Thilanka-Dissanayake/2D-Drawing-Bot/16882 Final Report_1a57fe1e69968b14cc38ac35d5213708.pdf

## DEPARTMENT OF PHYSICS

## UNIVERSITY OF COLOMBO

Embedded System Laboratory (PH3032)

## 2D Drawing Machine

By Serial Communication

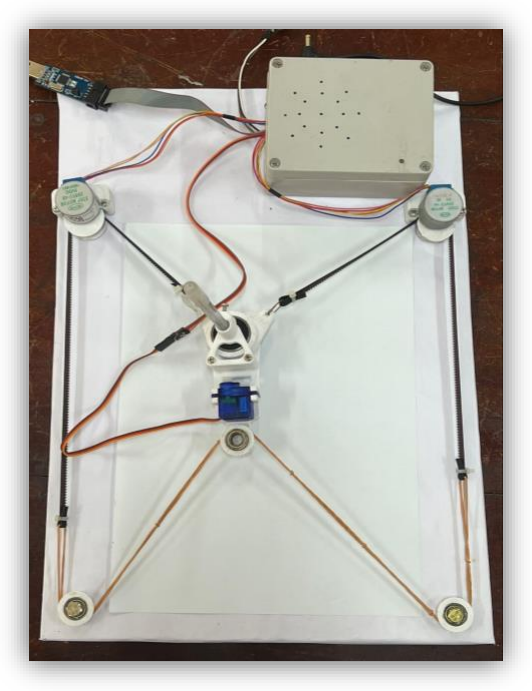
[picture p1: figure]

Name: Thilanka Dissanayake

Index No: 16882

Registration No: 2022s19374

Date: September 15, 2025

## 1. Abstract

This report presents a detailed account of the design, development, and testing of a 2D Drawing Machine, a low-cost Cartesian plotter controlled by a personal computer. The primary objective of this project was to create an educational tool demonstrating core concepts in embedded systems, mechatronics, and automation. The system architecture is centered around an ATmega328P microcontroller, which orchestrates the movement of two 28BYJ-48 stepper motors for X-Y axis control and a SG90 servo motor for actuating a pen-lift mechanism.

A custom-designed Printed Circuit Board (PCB) integrates the microcontroller with motor drivers and other peripheral components, ensuring a stable and compact hardware foundation. The mechanical structure is built using 3D-printed parts, bearings, and a belt-drive system to translate motor rotation into precise linear motion.

Communication between a host PC and the microcontroller is achieved via a USB-TTL serial interface, enabling the transmission of drawing commands. The firmware, written in C, implements a parser for a G-code-like command set and utilizes Bresenham's line algorithm for efficient, integer-based path interpolation. On the host side, a Python script provides a high-level interface for users, containing functions to draw various predefined geometric shapes and patterns by generating and sending the appropriate command sequences.

Performance tests demonstrate the machine's ability to successfully render complex shapes with reasonable accuracy. Analysis of the results identified potential sources of error, including mechanical backlash, belt tension inconsistencies, and motor step resolution. The project successfully meets its objectives, serving as a functional prototype and a robust platform for future enhancements in the field of hobbyist CNC technology.

## 2.Introduction

## 2.1. Background and Motivation

In the modern era of digital fabrication, Computer Numerical Control (CNC) has become a cornerstone technology, enabling the automated creation of complex parts with high precision. From industrial milling machines to desktop 3D printers, the principle remains the same: translating digital designs into physical objects through controlled motion. The 2D plotter is one of the earliest and most intuitive forms of CNC technology, providing a clear visual representation of digital path planning and motion control.

The motivation for this project stems from a desire to explore these foundational concepts in a hands-on, accessible manner. While commercial CNC machines are often expensive and complex, building a plotter from the ground up provides invaluable insight into the interplay between hardware, firmware, and software. This project, the "2D Drawing Machine," was conceived as an educational endeavor to design and implement a complete mechatronic system using readily available, low-cost components.

## 2.2. Objectives

The primary objectives of this project were defined as follows:

- Design and build a functional Cartesian plotter - capable of moving a pen in a 2D plane.
- Develop a custom electronic control system - based on the ATmega328P microcontroller, including the design and fabrication of a custom PCB.
- Write robust firmware in C - to manage motor control, interpret commands, and execute motion paths using an efficient algorithm.
- Create a user-friendly Python control script - for sending drawing commands from a PC to the plotter via serial communication.
- Achieve reasonable drawing accuracy - for a variety of predefined geometric shapes.
- Document the entire process - including design choices, challenges faced, and potential areas for improvement.

## 2.3. Scope and Limitations

The project's scope is focused on creating a proof-of-concept plotter. It is designed to draw single-color line art from a set of predefined functions. The machine operates on a small drawing area (approximately A5 paper size) and is not intended for high-speed or highprecision applications. Limitations include the inherent speed and torque constraints of the 28BYJ-48 stepper motors, the mechanical rigidity of the 3D-printed frame, and the simplicity of the G-code interpreter, which does not support advanced features like arc interpolation or buffered commands.

## 3.Theoretical Principles

## 3.1. ATmega328P Microcontroller Architecture

The ATmega328P is the central processing unit of the 2D Drawing Machine. It is a highperformance, low-power 8-bit microcontroller based on the AVR enhanced RISC architecture. Its versatility and extensive community support make it an ideal choice for this project

3.1.1 Core and Memory

The ATmega328P features 32 KB of In-System Programmable Flash memory for program storage, 2 KB of SRAM for data variables during runtime, and 1 KB of EEPROM for nonvolatile data storage. The RISC architecture with 131 powerful instructions allows most instructions to execute in a single clock cycle, achieving throughputs approaching 1 MIPS per MHz.

3.1.2 Peripherals

The firmware for this project utilizes several of the ATmega328P's built-in peripherals:

- General Purpose I/O (GPIO):
The GPIO pins on PORTB and PORTD are configured as outputs to send the stepping signals to the ZC-A0591 motor drivers and the PWM signal to the servo motor.
- Timers/Counters:
The 16-bit Timer1 is used in Fast PWM mode to generate the precise 50 Hz PWM signal required for controlling the servo motor's angle. Its configuration involves setting the pre scaler and top value (ICR1) to define the period, and the compare match value (OCR1B) to define the duty cycle.
- Universal Synchronous/Asynchronous Receiver/Transmitter (USART):
The USART module is configured for asynchronous serial communication at a baud rate of 9600 bps to receive commands from the host PC.

## 3.2 Stepper Motor Control

3.2.1 Principles of the 28BYJ-48 Motor

The 28BYJ-48 is a 5-wire unipolar stepper motor. Internally, it has a step angle of 5.625°, meaning it takes 360/5.625=64 steps to complete one full revolution of its rotor. However, it also includes an internal 1/64 reduction gearbox. This results in an effective step count of 64×64=4096 steps per full revolution of the output shaft, providing very high resolution at the cost of speed.

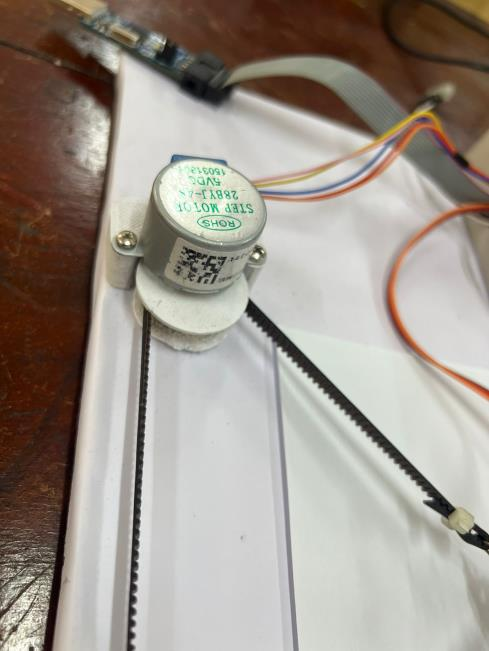
[picture p2: figure]

## Figure 3.1. The stepper motor

3.2.2 ZC-A0591 Driver

The ATmega328P cannot directly provide the current required to drive the stepper motor coils. The ZC-A0591 driver board, which features a ULN2003 Darlington transistor array, acts as a current amplifier. It takes the low-current logic signals from the microcontroller's pins and switches the high-current path from the 5V power supply to the motor coils.

3.2.3 Stepping Modes

The firmware drives the motors using a half-step sequence. In this mode, both single coils and pairs of adjacent coils are energized sequentially. This doubles the motor's resolution (to 8 steps per cycle) and provides smoother rotation compared to full-stepping.

## 3.3 Servo Motor Control

3.3.1 Principle of Operation

The micro servo is a closed-loop control system. It consists of a DC motor, a gearbox, a position feedback potentiometer, and a control circuit. The control circuit receives a PWM signal and compares the corresponding target angle with the current angle read from the potentiometer. It then drives the DC motor until the difference between the two is zero, allowing for precise angular positioning.

3.3.2 Pulse Width Modulation (PWM) on ATmega328P

Standard servos operate on a PWM signal with a 20 ms (50 Hz) period. The width of the pulse within this period determines the angle:

- A ~1 ms pulse corresponds to 0°.
- A ~1.5 ms pulse corresponds to 90° (neutral).
- A ~2 ms pulse corresponds to 180°.

The firmware configures Timer1 in Fast PWM mode with ICR1 set to 19999 and a prescaler of 8. With an 8 MHz clock, this creates a 50 Hz period. The

OCR1B register is then set to a value between 1000 (1 ms) and 2000 (2 ms) to control the pen's angle.

## 3.4 Serial Communication Protocol (UART)

3.4.1 Asynchronous Data Transfer

UART is a form of asynchronous serial communication, meaning no clock signal is shared between the transmitter and receiver. Instead, the data is framed with a start bit and a stop bit to allow the receiver to synchronize. The data format used in this project is 8-N-1 (8 data bits, no parity bit, 1 stop bit), a common standard.

3.4.2 Baud Rate Configuration

Both the PC and the ATmega328P must be configured to operate at the same baud rate (9600 bps) for successful communication. In the firmware, this is achieved by loading a calculated value into the UBRR0 register. The formula used is

UBRR = (FCPU /(16×BAUD)) − 1

For an 8 MHz CPU frequency and 9600 baud, the UBRR value is approximately 51.

# 3.5 Motion Planning: Bresenham's Line Algorithm

## 3.5.1 Algorithm Overview

To draw a line from (x0 ,y0 ) to (x1 ,y1 ), the plotter needs to execute a series of discrete steps in X and Y. Bresenham's algorithm is an optimal method for determining this sequence. It maintains an integer error term that represents the deviation of the current pixel grid point from the true mathematical line. At each iteration, it decides the next step (in X, Y, or diagonally) based on the sign of this error term, then updates the error term accordingly.

## 3.5.2 Implementation Logic

The draw_line function in the C firmware implements this algorithm. It first calculates the total steps required in X (dx) and Y (dy) and their directions (sx, sy). It then enters a loop that continues until both steps_x and steps_y counters reach zero. Inside the loop, an error term err is compared. If the error term indicates that the path is drifting too far in one direction, a corrective step is made in the other direction. This ensures the plotted line remains as close as possible to the ideal straight line, using only efficient integer arithmetic.

# 4. Methodology and Implementation

# 4.1 System Design Overview

The system is divided into three main subsystems:

1. Mechanical System: The physical plotter frame, belts, and pen holder.
2. Electronic System: The custom PCB with the ATmega328P, motor drivers, and power supply.
3. Software System: The C firmware on the microcontroller and the Python control script on the PC.

A user interacts with the Python script, which sends high-level commands. The firmware receives these commands, performs low-level motion planning, and drives the motors to create the final drawing.

# 4.2 Mechanical Design and Assembly

## 4.2.1 Cartesian Frame

The machine's structure was built primarily from 3D-printed parts, designed to be lightweight and easy to assemble. The design follows a CoreXY-like belt arrangement where the position of the central carriage is determined by the coordinated movement of both stepper motors. This design minimizes the moving mass, as the motors themselves are stationary. Copper-coated anti-slip belts are used to transmit motion from the motor pulleys to the pen carriage, with bearings serving as idler pulleys to maintain belt tension and ensure smooth motion.

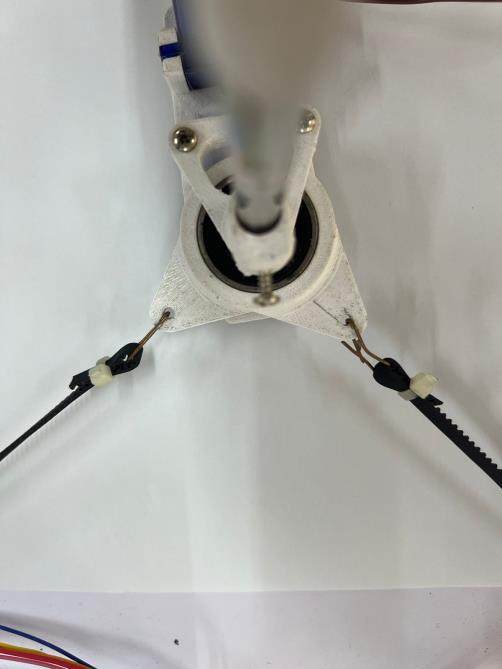
[picture p3: figure]

Figure 4.1.

## 4.2.2 Pen Lift Mechanism

The pen is held in a 3D-printed holder attached to the central carriage. A micro servo motor is mounted on this carriage, with its horn connected to a lever that lifts the entire pen holder assembly up and down. This simple yet effective mechanism allows the machine to move between points without drawing on the paper

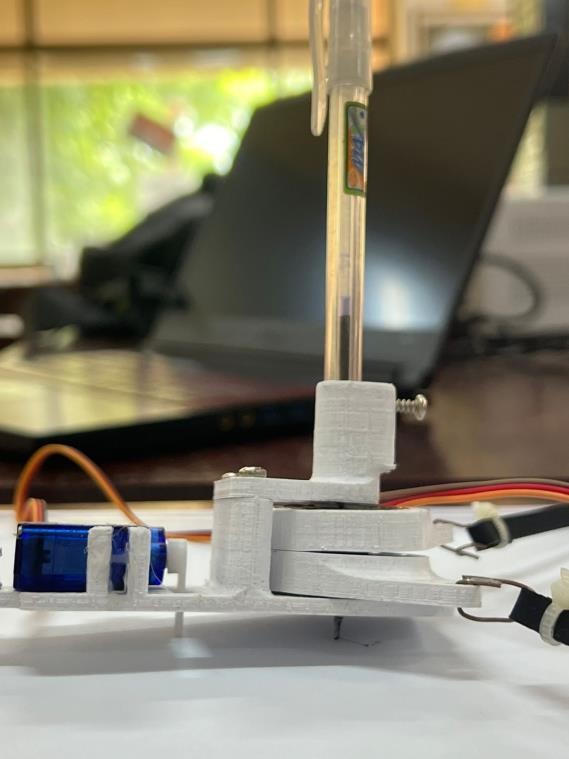
[picture p4: figure]

## Figure 4.2. Operation of the servo motor

# 4.3 Hardware Design and Components

## 4.3.1 Hardware Components

- 1 ATmega328P-PU Microcontroller
- 2 28BYJ-48 Stepper Motors with ZC-A0591 Drivers
- 1 Micro Servo Motor SG90
- 1 USB-TTL CH340 Adapter for Serial Communication
- 1 5V 2A DC Power Adapter
- 3 (8-16mm) Bearings and 2 (12-28mm) Bearings
- 1 Custom designed single-layer PCB with Required Components|
- 3D Printed Parts & belts

## 4.3.2 Component Selection Rationale

- ATmega328P: Chosen for its low cost, wide availability, extensive documentation, and sufficient peripherals for this application.
- 28BYJ-48 Steppers: Selected due to their very low cost and high resolution, making them suitable for a budget-friendly, proof-of-concept plotter where speed is not a primary concern.
- Micro Servo: A standard, inexpensive solution for simple actuation tasks like the pen lift.
- 5V 2A Power Supply: Chosen to provide adequate current for both stepper motors (which can draw several hundred mA each) and the servo, ensuring stable operation.

# 4.4 PCB Design and Schematic

## 4.4.1 Schematic Description

The schematic, designed in EasyEDA, outlines all electrical connections. The ATmega328P is the central component. The schematic includes a 16 MHz crystal oscillator circuit, a reset button with a pull-up resistor, and headers for connecting the two stepper drivers (8 pins total), the servo (3 pins), and the USB-TTL adapter (for power, ground, RX, TX). The motor drivers are powered directly from the main 5V input, while the ATmega328P's VCC is also connected to this rail, potentially through a filtering inductor and capacitor to reduce motor noise.

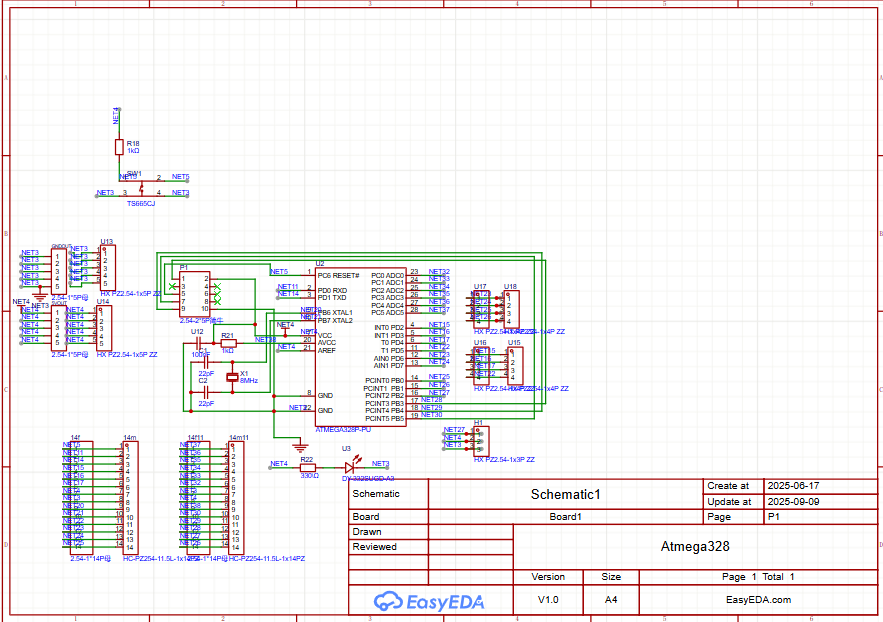
[picture p5: figure]

## Figure 4.1: Circuit Schematic

## 4.4.2 PCB Layout

The PCB is a single-sided board designed for easy home fabrication. Component placement was optimized to keep related components close. Traces for the motor outputs are made wider to handle higher currents. A ground plane is used to improve signal integrity and reduce electrical noise generated by the motors. Headers are grouped logically for easy connection of the external modules.

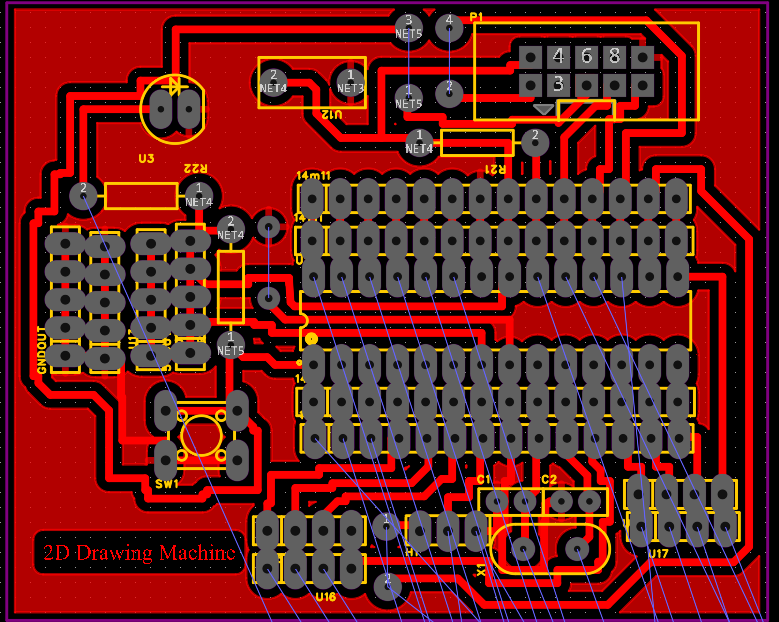
[picture p6: figure]

## Figure 4.2: PCB Layout

# 4.5 Firmware Development (C)

## 4.5.1 Development Environment

The firmware was written in C using an AVR toolchain (avr-gcc, avr-libc) and programmed onto the ATmega328P using an external programmer via the ICSP header on the PCB.

## 4.5.2 Firmware Architecture

The firmware's architecture is based on a simple super-loop. After an initial setup phase, the main function enters an infinite while(1) loop. Inside this loop, it continuously checks for incoming serial data. When a newline character is received, the assembled command string is passed to the process_gcode_command function for parsing and execution. This is a blocking, single-tasking architecture, sufficient for the requirements of this project.

## 4.5.3 Peripheral Initialization

The setup_pins() function configures the data direction registers (DDRB, DDRD) for all motor control pins as outputs. The USART_Init() function configures the baud rate and enables the UART transmitter and receiver. The timerservo_init() function configures Timer1 for Fast PWM mode to drive the servo.

## 4.5.4 Command Processing

The process_gcode_command function acts as the core of the firmware's logic. It uses strcmp and strncmp to identify commands:

- M3/M5: Directly call servo_set_angle to lift or lower the pen.
- G28 (Home): Calculate the steps needed to move from the current_x, current_y position back to (0,0) and execute the movement.
- G1 (Linear Move): Parses the command string using atoi to extract the target X and Y coordinates. It then calculates the delta steps required and calls execute_movement, which in turn calls draw_line. Finally, it updates the global current_x and current_y variables.

# 4.6 Control Software Development (Python)

## 4.6.1 Software Architecture

The Python script is object-oriented, with a DrawingRobot class that encapsulates all communication and control logic. Upon instantiation, the class constructor initializes the serial connection via the pyserial library and waits for a "Ready" message from the firmware, confirming the connection is live. The class provides methods like move_to, pen_up, and pen_down that abstract the underlying G-code commands.

## 4.6.2 High-Level Shape Functions

The script includes functions like draw_square, draw_triangle, and draw_heart. Each of these functions contains the geometric logic to generate a series of (X, Y) waypoints for that shape. It then calls the basic

move_to, pen_down, and pen_up methods in the correct sequence to draw the shape on the machine. For example, draw_square calculates the coordinates of the four corners and sends four G1 commands between them. The draw_heart function uses a parametric equation to generate a dense set of points to approximate a smooth curve.

# 5. Results and Analysis

# 5.1 Experimental Setup

The machine was placed on a flat, stable surface. An A5 sheet of paper was secured to the drawing platform. The machine was powered on with a 5V 2A DC adapter, and the USB-TTL adapter was connected to a host PC running the Python control script. The

draw_shapes.py script was executed from the command line, specifying the correct serial port.

# 5.2 Qualitative Results

The machine was commanded to draw a sequence of shapes, including a square, star, triangle, heart, and letters. The output was visually inspected. The machine successfully drew all shapes, demonstrating that the end-to-end system was functional. The lines were continuous, and the pen lift mechanism worked reliably between separate drawing paths.

Figure 5.1: Sample output of Rectangle from the 2D Drawing Machine.

Figure 5.2: Sample output of Triangle from the 2D Drawing Machine.

Figure 5.3: Sample output of Star from the 2D Drawing Machine.

Figure 5.4: Sample output of Heart from the 2D Drawing Machine.

Figure 5.5: Sample output of House from the 2D Drawing Machine.

The drawings are clearly recognizable. However, some minor artifacts are visible upon close inspection, such as slight waviness in straight lines, Pen lift issues and rounded corners, which are analyzed below.

# 5.3 Error Analysis

Several sources contribute to the observed inaccuracies:

- Mechanical Backlash: There is inherent play in the gearboxes of the 28BYJ-48 motors and slack in the belt system. This causes a small amount of lost motion when the direction of movement changes, leading to rounded corners and slight inaccuracies.
- Frame Rigidity: The 3D-printed frame can flex slightly during rapid movements, causing vibrations that manifest as wavy lines.
- Motor Step Loss: If the pen experiences too much friction or the machine attempts to move too fast, the motors may not have enough torque to complete a step, causing the machine to lose its position. This is mentioned as a potential issue in the user manual's troubleshooting section.
- Belt Tension: Uneven or inadequate belt tension can lead to slipping or stretching, resulting in dimensional inaccuracies and skewing of the drawing.
- Pen Tip Friction: The friction between the pen tip and the paper creates a drag force that the motors must overcome. Variations in this friction can affect positioning accuracy.
- Servo Motor Torque Limitations: The SG90 micro servo motor is lightweight and inexpensive, but it has limited power. When used to lift the pen, the total weight of the pen holder, the pen itself, and especially the 12-28mm bearings in the assembly can exceed the motor's torque capacity.

# 6. Discussion

# 6.1 Performance Evaluation

The 2D Drawing Machine successfully meets all the primary objectives outlined for the project. It demonstrates a complete, functional mechatronic system capable of translating digital commands into physical drawings. The modular design, combining a custom PCB with 3D-printed parts and a Python control interface, proved to be an effective and flexible approach. The firmware's implementation of Bresenham's algorithm is efficient and the G-code-like protocol is robust enough for the intended tasks. The project serves as an excellent educational platform for learning about CNC principles in a practical setting.

# 6.2 Challenges and Solutions

- Challenge: Initial motor movements were jerky and inaccurate.
- Solution: The issue was traced to the stepping mode. Switching from a full-step to a half-step sequence in the firmware (stepper_sequence array) resulted in much smoother motion.
- Challenge: The machine would occasionally lose its position during longer drawings.
- Solution: This was identified as motor step loss due to insufficient power. The troubleshooting guide in the user manual suggests verifying the 5V 2A power supply is used. Additionally, the _delay_ms(1) in the step_motor function was crucial to give the motors time to complete each step, reducing the chance of stalls.
- Challenge: Calibrating the drawing size to match real-world units.
- Solution: The UNIT_STEPS constant in the firmware required significant trialand-error adjustment. A calibration procedure was developed where a line of known length was commanded, and the constant was adjusted until the drawn length matched the expected length.

# 6.3 Future Improvements

While the project was successful, there are numerous avenues for enhancement:

- Upgrade Drive System: Replace the 28BYJ-48 motors with NEMA 17 stepper motors and A4988 drivers. This would dramatically increase speed, torque, and accuracy.
- Improve Mechanical Design: Utilize linear rails or metal rods instead of a purely 3D-printed guide system to increase rigidity and reduce vibrations.
- Advanced Firmware: Implement a command buffer (circular buffer) in the firmware to store multiple G-code commands. This would allow for look-ahead planning and acceleration/deceleration control, resulting in smoother and faster movements, especially for curves.
- Implement Closed-Loop Control: Add rotary encoders to the motors to provide positional feedback, allowing the firmware to detect and correct for lost steps.
- Develop a Graphical User Interface (GUI): Create a desktop application using a framework like PyQt or Tkinter that allows users to load, preview, and draw standard vector graphics files (e.g., SVG), rather than being limited to hard-coded shapes.
- Text Writing: Create python script would have pre-defined G-code templates for each letter, which it would then execute one by one to form words and sentences. This would transform the machine into a simple text-writing robot.
- Image-to-G-code Conversion: Develop a software pipeline that takes a simple blackand-white image as input and converts it into a series of G-code commands. This process would involve edge detection or image tracing to identify the lines and contours, which are then translated into linear (G1) move commands. The Python script could then read and send these commands to the machine, allowing it to "sketch" simple pictures.

# 7. Conclusion

The Design and Implementation of a PC-Controlled 2D Drawing Machine project successfully resulted in the creation of a functional and educational Cartesian plotter. By integrating an ATmega328P microcontroller, stepper and servo motors, a custom PCB, and a Python-based control interface, the project comprehensively covered key aspects of embedded systems engineering and mechatronics. The machine demonstrated its capability to draw various geometric shapes with a degree of accuracy suitable for its low-cost, hobbyist nature.

The development process provided critical insights into the challenges of motion control, including mechanical precision, motor limitations, and the importance of robust firmware. The final prototype, while having scope for improvement, stands as a testament to the power of integrating simple, accessible components to create a complex automated system. It not only fulfills all its initial objectives but also serves as a versatile platform for future exploration and enhancement in the field of digital fabrication.

# 8. Appendix

# 8.1. The C code

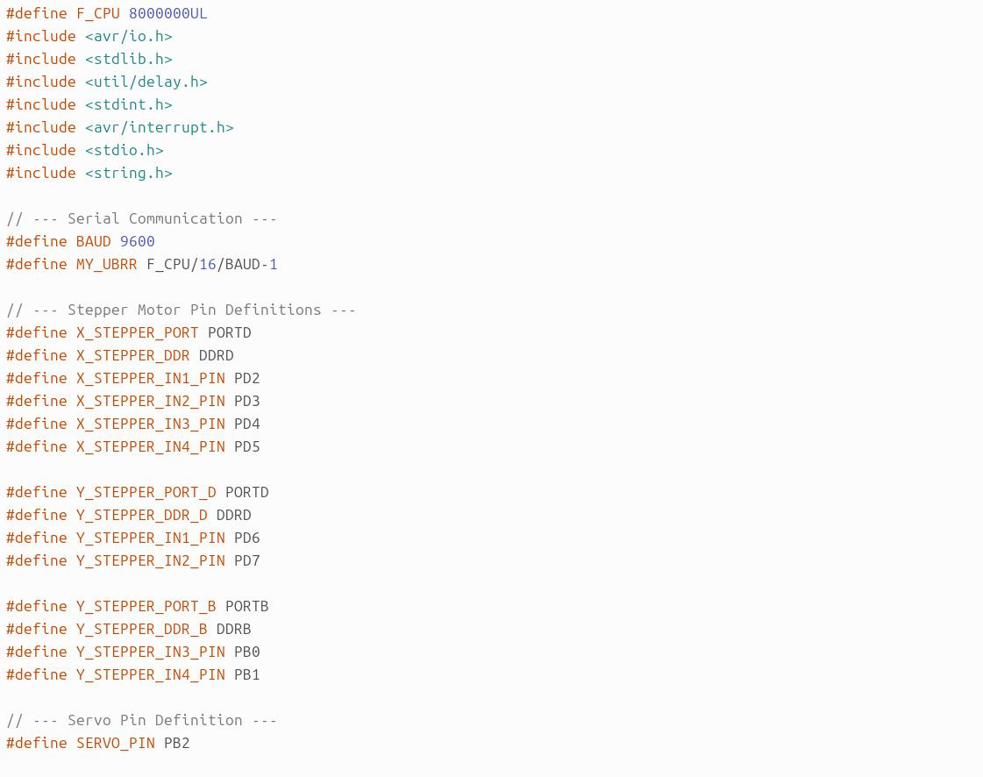
[picture p7: figure]

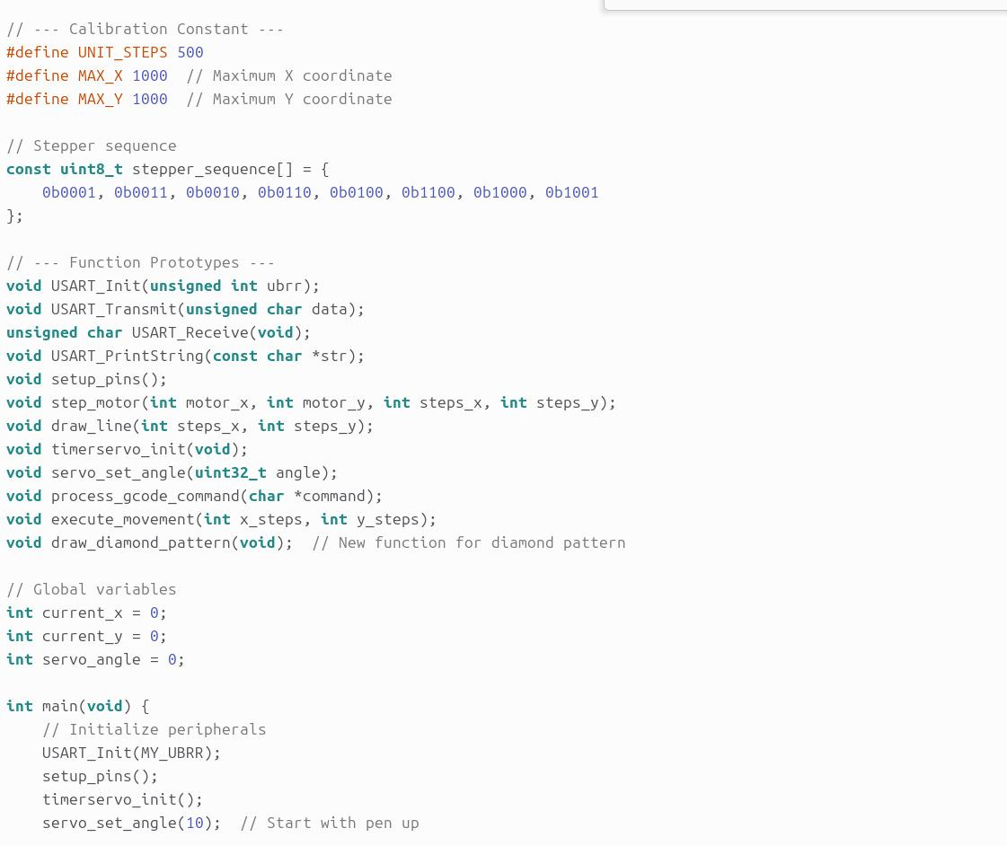
[picture p8: figure]

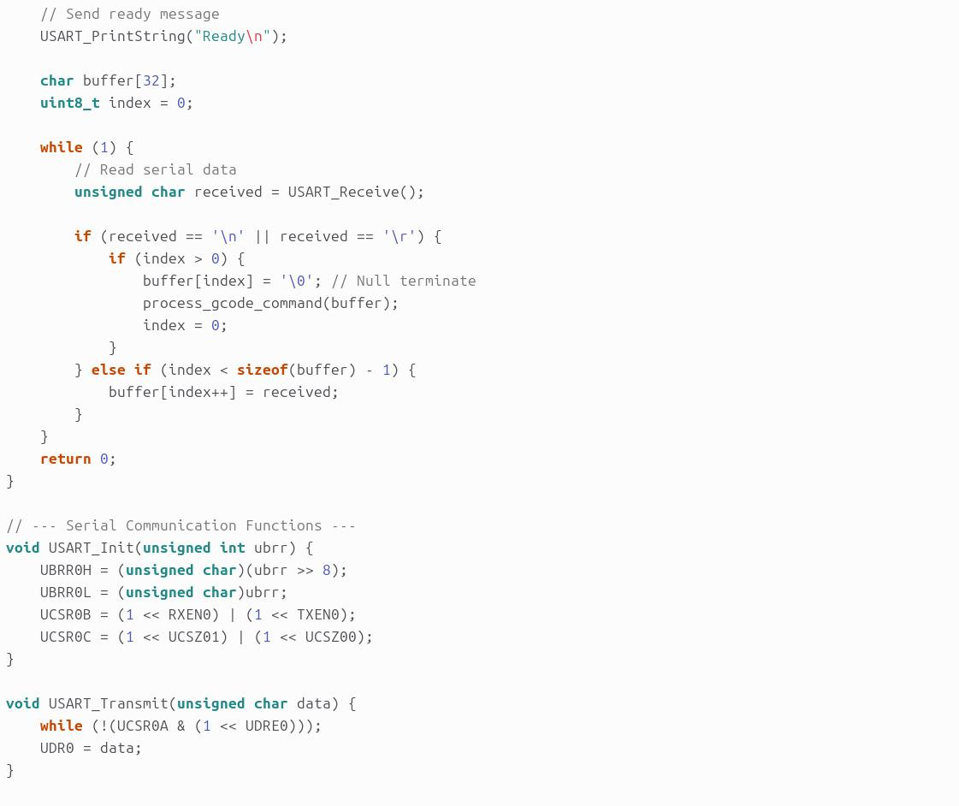
[picture p9: figure]

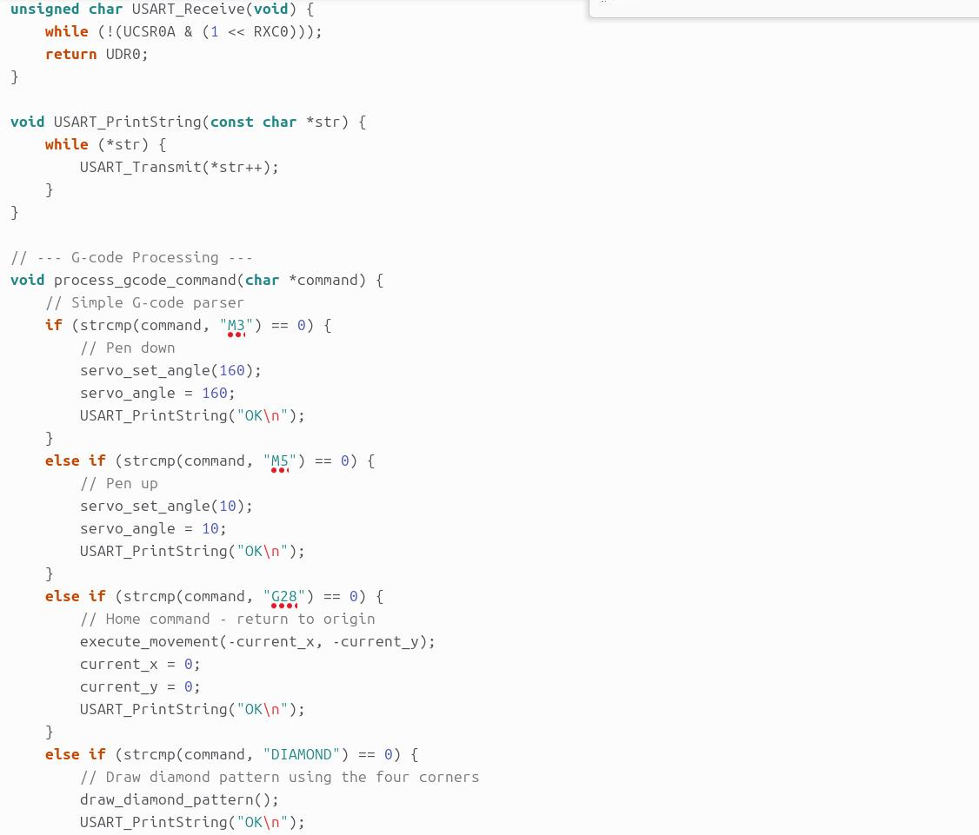
[picture p10: figure]

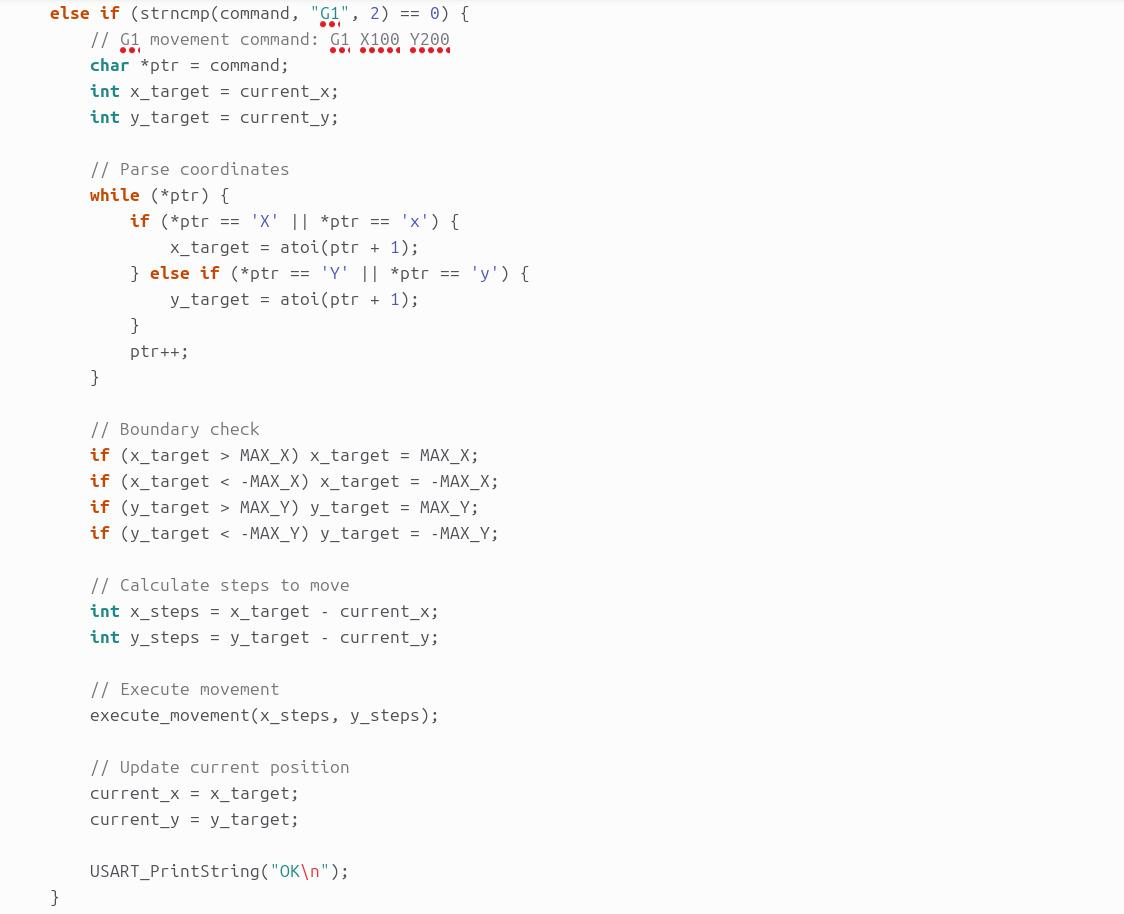
[picture p11: figure]

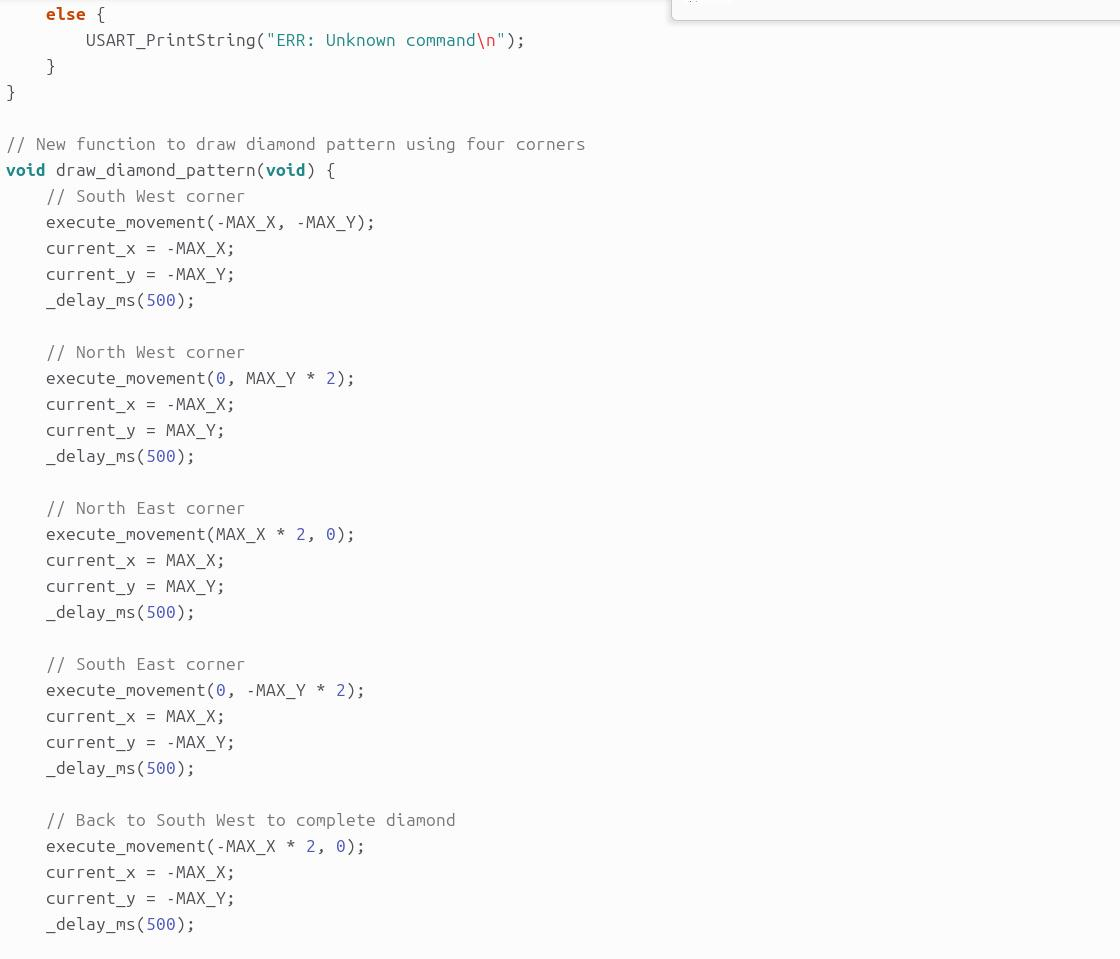
[picture p12: figure]

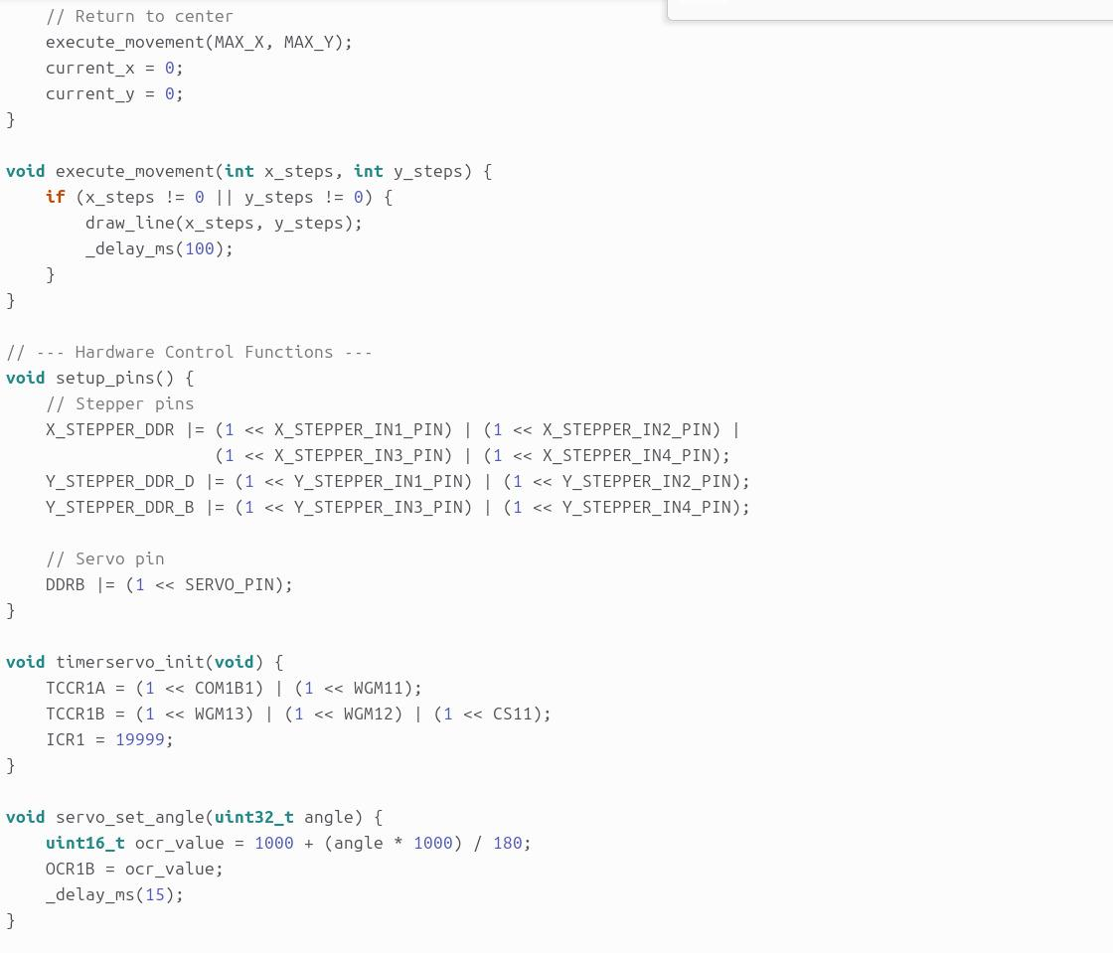
[picture p13: figure]

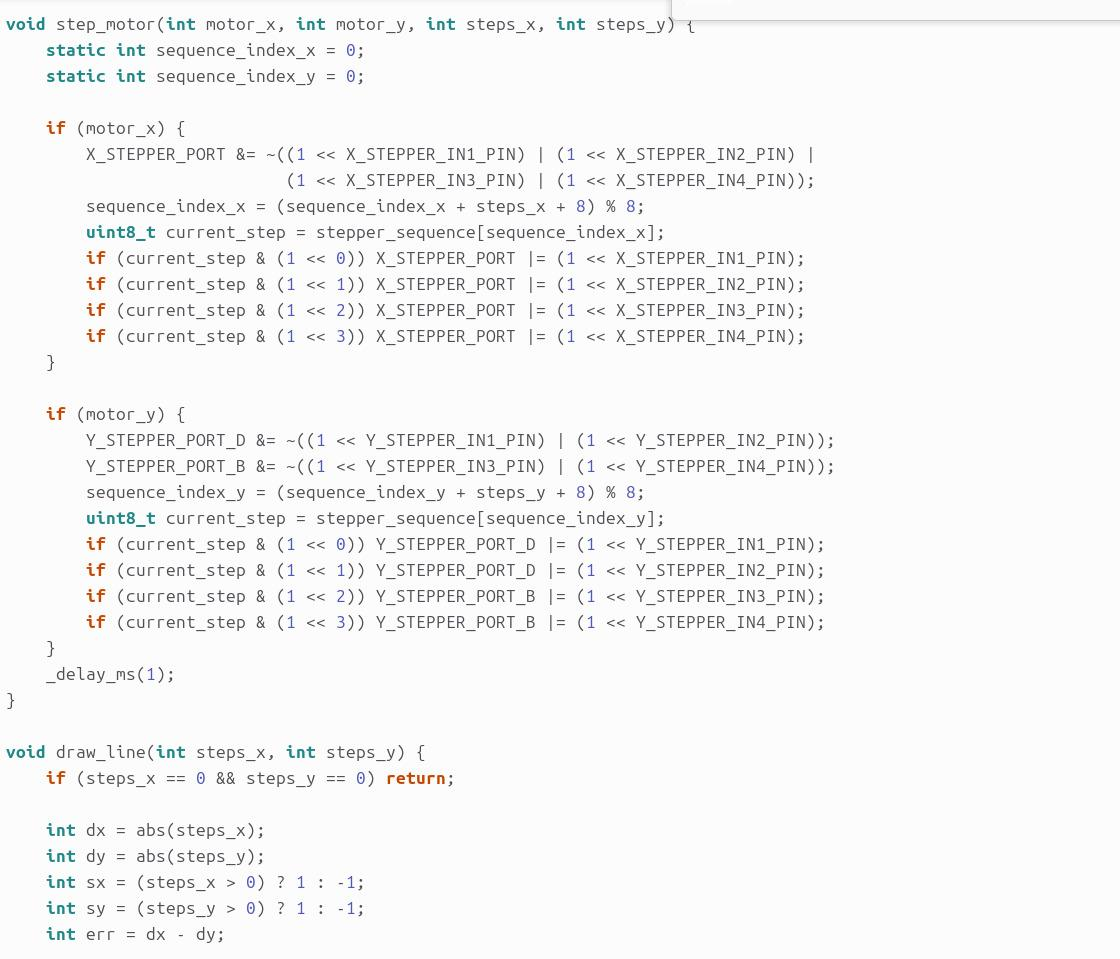
[picture p14: figure]

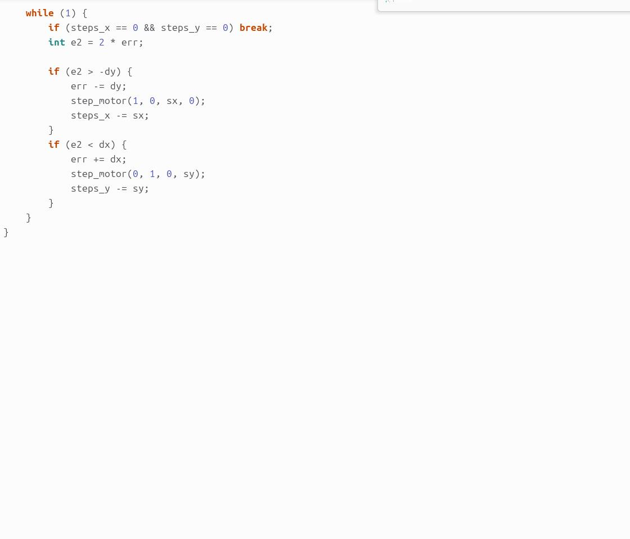
[picture p15: figure]

# 8.2. The Python code

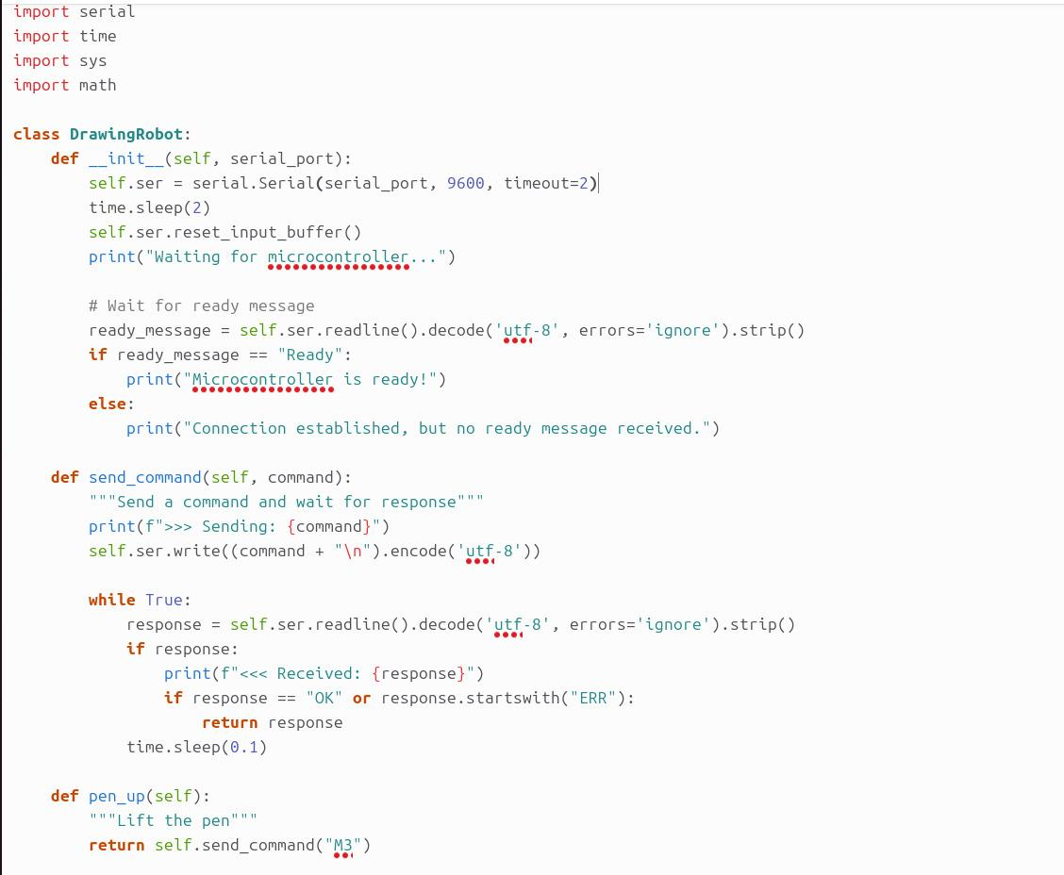
[picture p16: figure]
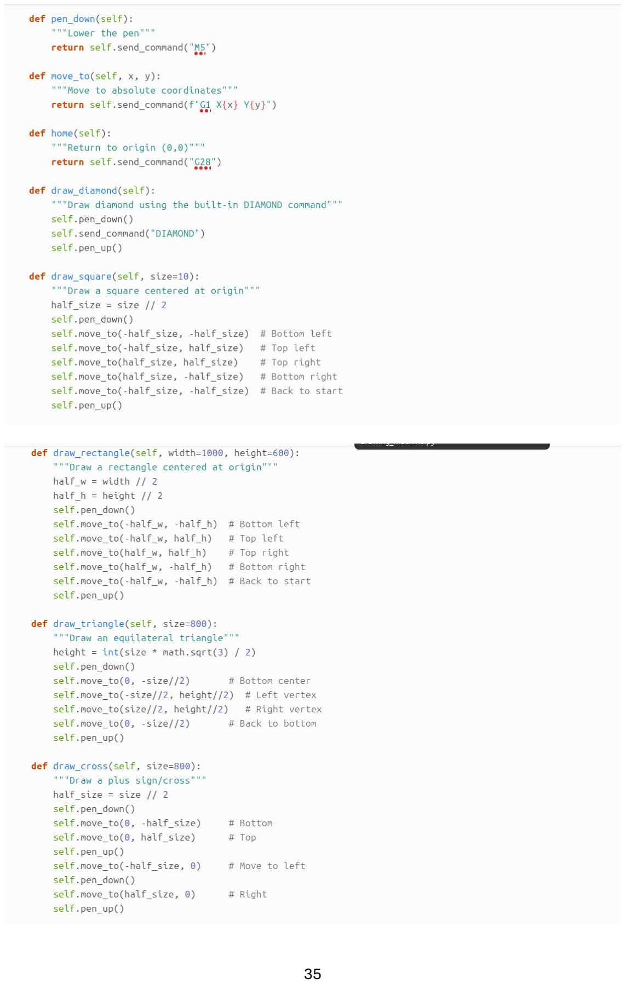
[picture p17: page 35]

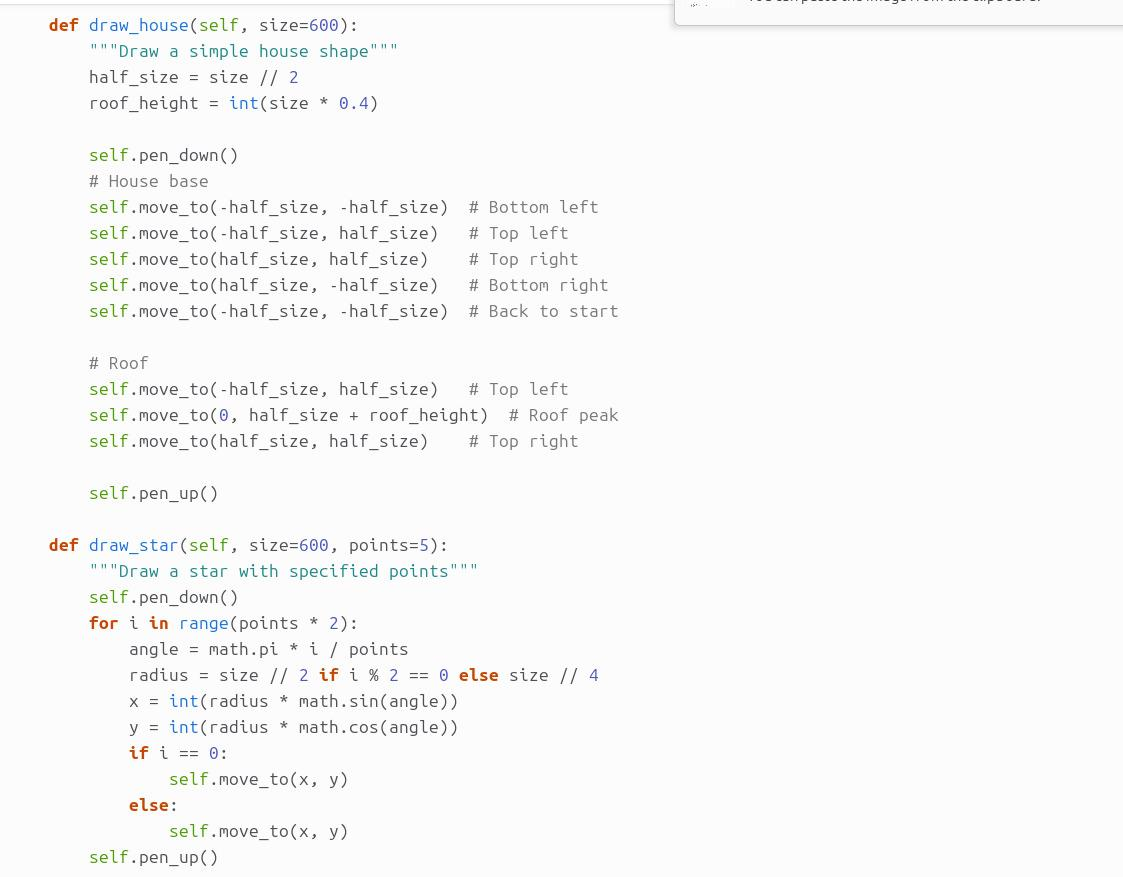
[picture p18: figure]

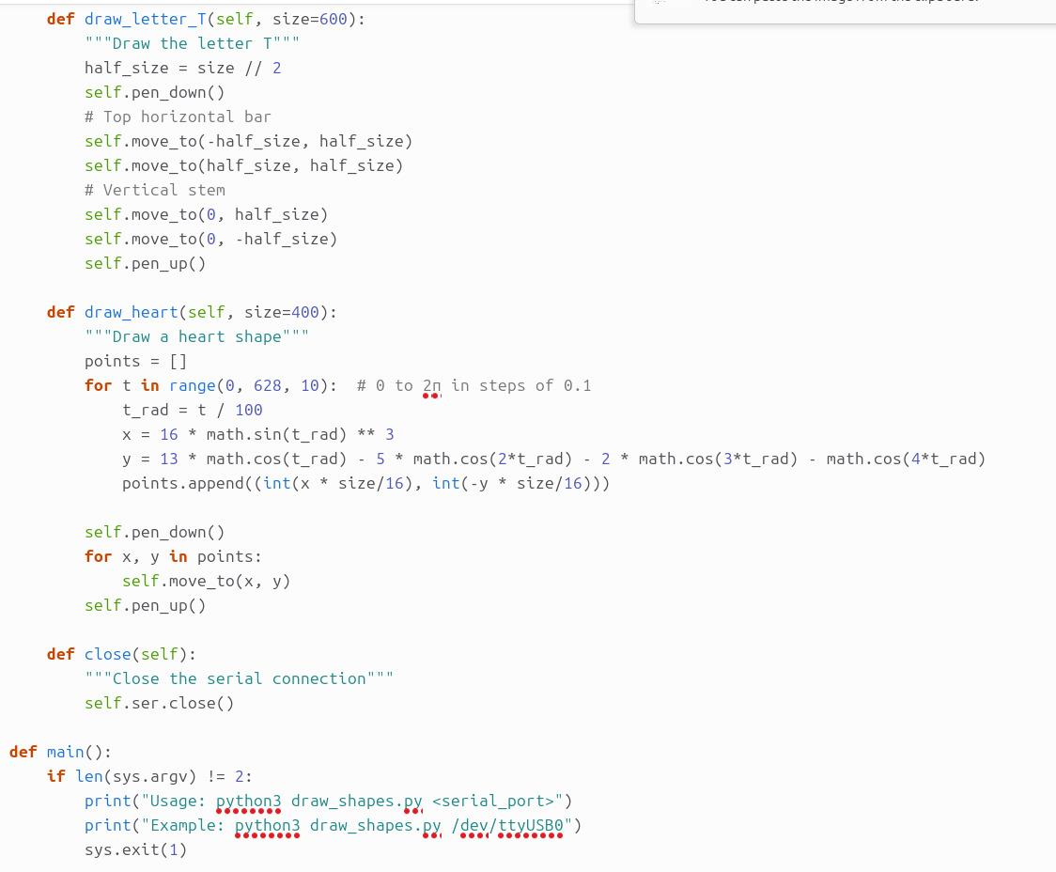
[picture p19: figure]
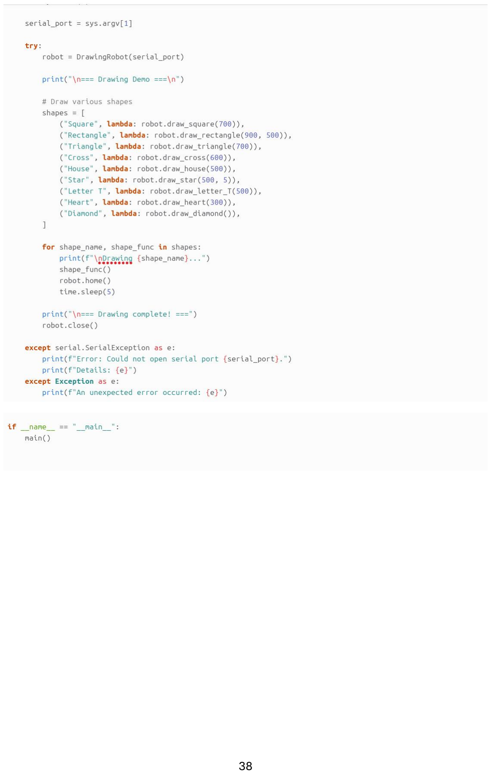
[picture p20: page 38]
